cnnben002/SHARC-Buoy-Power-Module/(list of files, cad)

Other CAD files:
Power Module/Power Management Module V1.0/LIB_TC2030-MCP-NL/TC2030-MCP-NL/Allegro/tc2030-mcp-nl.psm
Power Module/Power Management Module V1.0/LIB_TC2030-MCP-NL/TC2030-MCP-NL/DEHDL/tc2030_mcp_nl/chips/chips.prt
Power Module/Power Management Module V1.1/LIB_TC2030-MCP-NL/TC2030-MCP-NL/Allegro/tc2030-mcp-nl.psm
Power Module/Power Management Module V1.1/LIB_TC2030-MCP-NL/TC2030-MCP-NL/DEHDL/tc2030_mcp_nl/chips/chips.prt
Power Module/Power Management Module V1.2/LIB_TC2030-MCP-NL/TC2030-MCP-NL/Allegro/tc2030-mcp-nl.psm
Power Module/Power Management Module V1.2/LIB_TC2030-MCP-NL/TC2030-MCP-NL/DEHDL/tc2030_mcp_nl/chips/chips.prt
