cnnben002/SHARC-Buoy-Power-Module/Power Module/Power Management Module V1.0/Power_Management_Module.kicad_pcb

## KiCad design Power Module/Power Management Module V1.0/Power_Management_Module.kicad_pcb (2022-11-06, an earlier design)

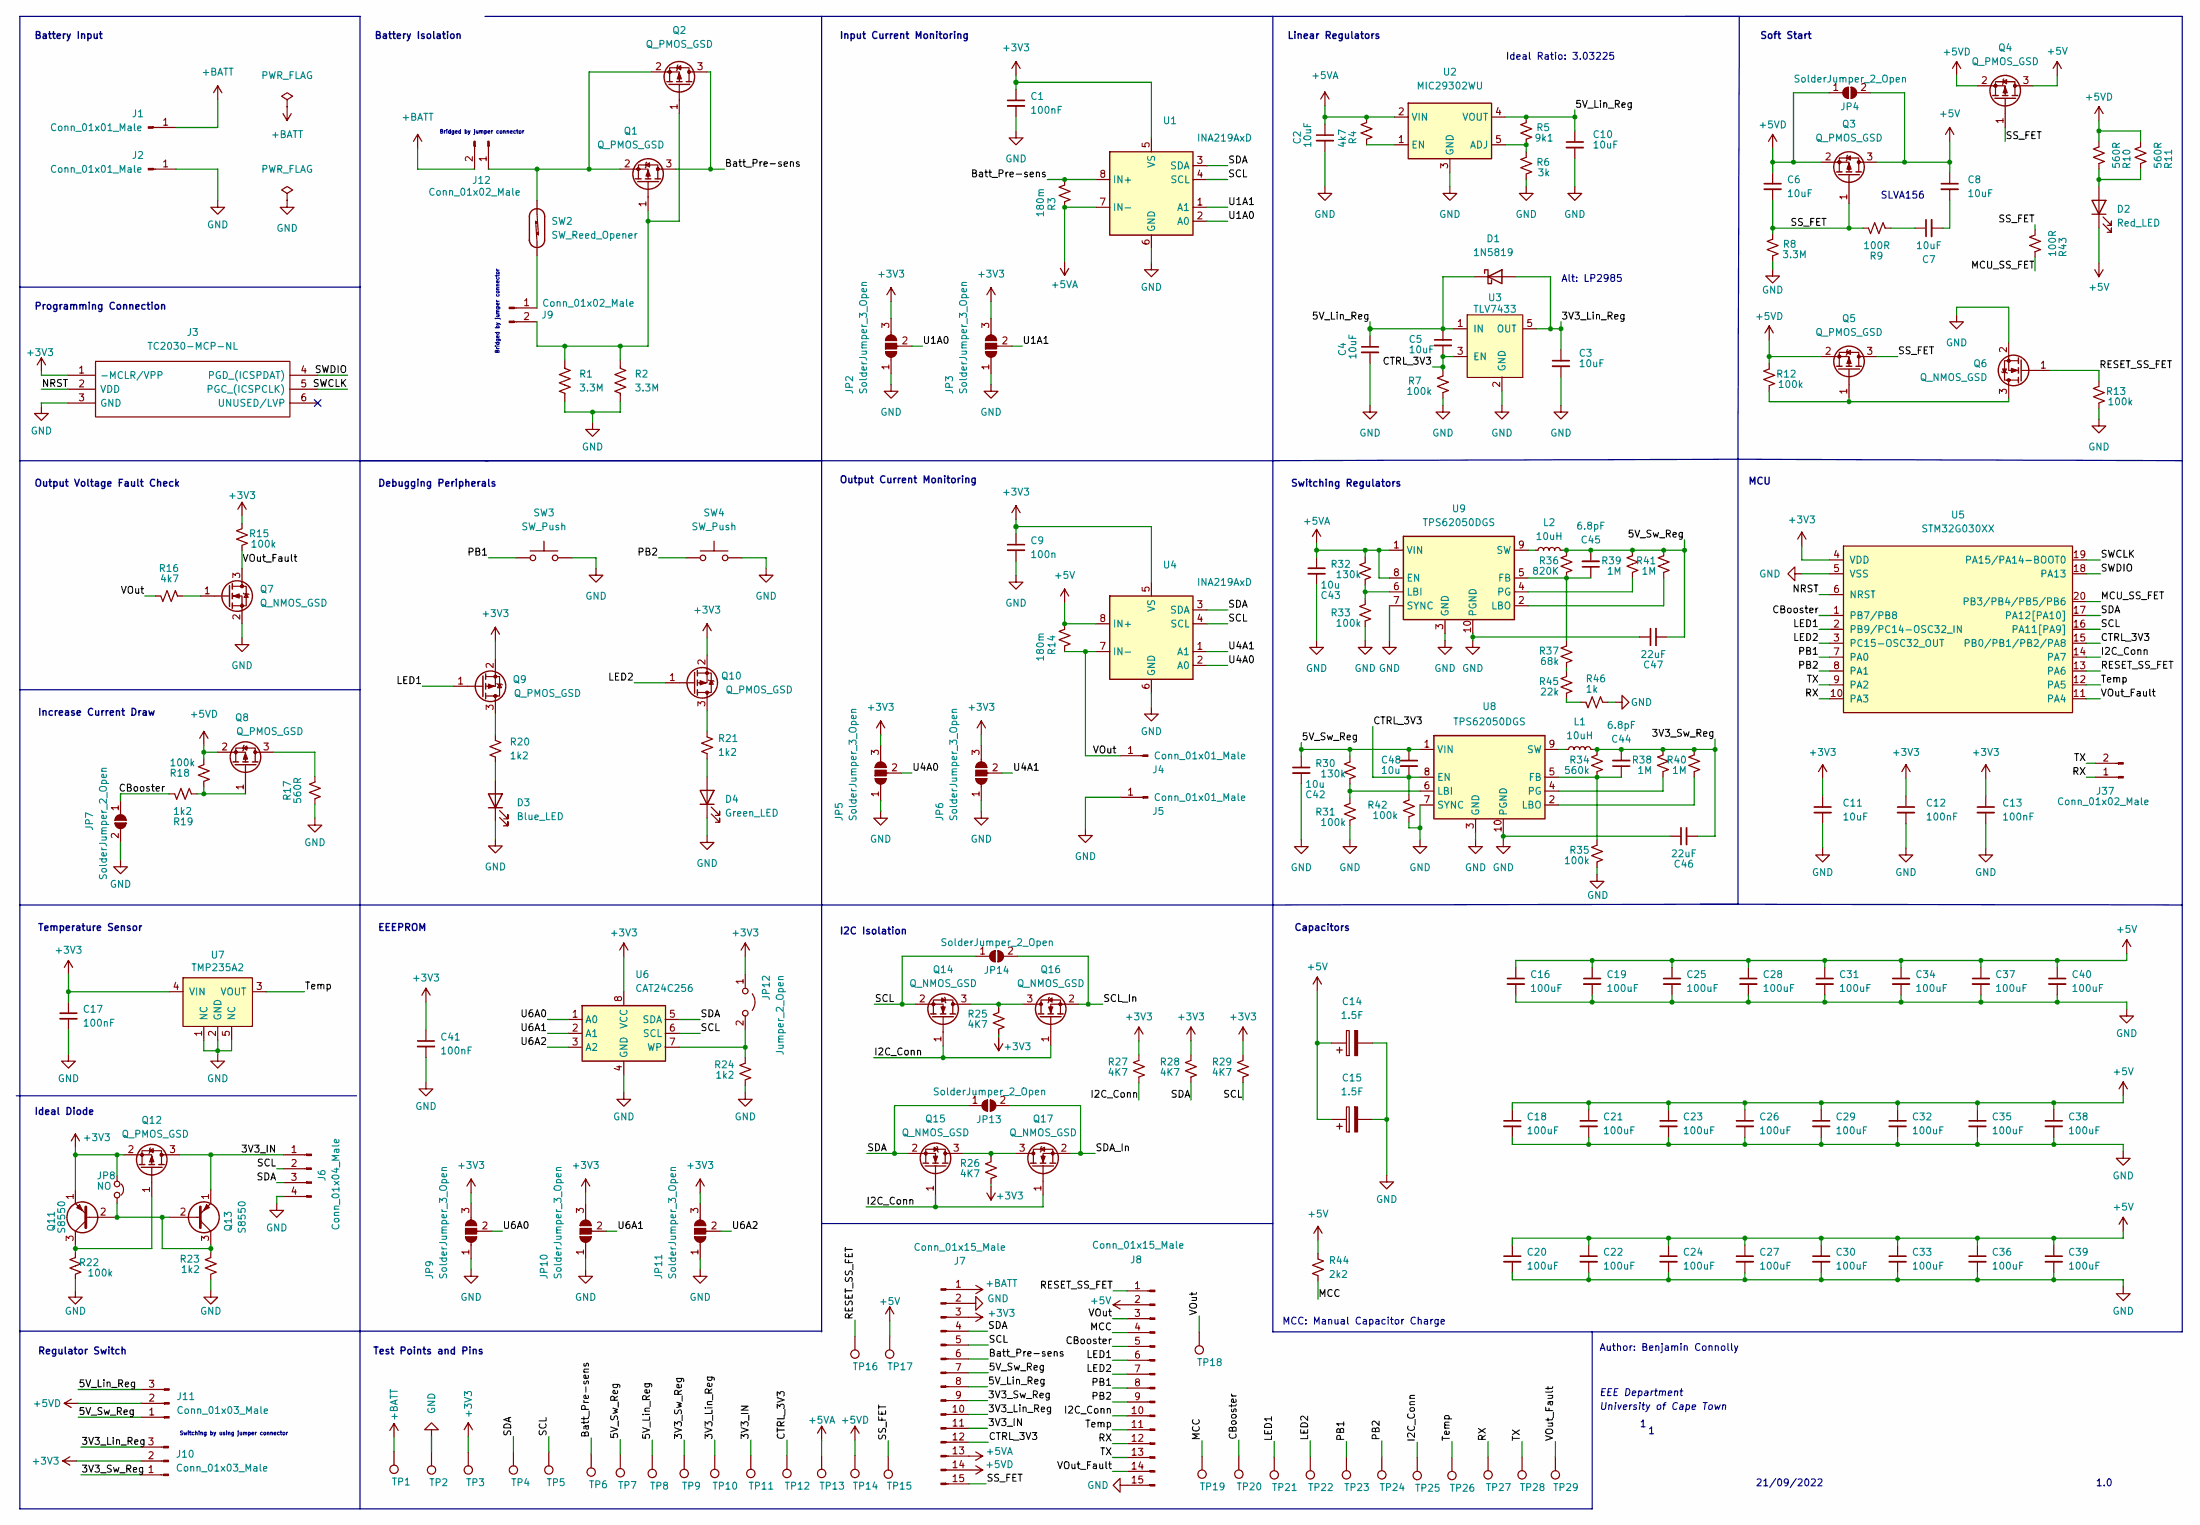
[picture p1: schematic Power_Management_Module.kicad_sch]

Parts:
C1, C12, C13, C41: 100nF; C_0402_1005Metric
C2, C3, C4, C5, C6, C7, C8, C10, C11: 10uF; C_0603_1608Metric
C9: 100n; C_0402_1005Metric
C14, C15: 1.5F; SP-5R5-Z155VY
C16, C18, C19, C20, C21, C22, C23, C24, C25, C26, C27, C28, C29, C30, C31, C32, C33, C34, C35, C36, C37, C38, C39, C40: 100uF; C_1206_3216Metric
C17: 100nF; C_1206_3216Metric
C42, C43, C48: 10u; C_0603_1608Metric
C44, C45: 6.8pF; C_0603_1608Metric
C46, C47: 22uF; CP_Elec_6.3x4.9
D1: 1N5819; D_SOD-323
D2: Red_LED; LED_0603_1608Metric
D3: Blue_LED; LED_0603_1608Metric
D4: Green_LED; LED_0603_1608Metric
J1, J2, J4, J5: Conn_01x01_Male; Battery_Pad
J3: TC2030-MCP-NL; Tag-Connect_TC2030-IDC-NL_2x03_P1.27mm_Vertical; Manufacturer_Part_Number TC2030-MCP-NL; Mouser Part Number 579-TC2030-MCP-NL
J6: Conn_01x04_Male; PinHeader_1x04_P2.54mm_Vertical
J7, J8: Conn_01x15_Male; PinHeader_1x15_P2.54mm_Vertical
J9, J12, J37: Conn_01x02_Male; PinHeader_1x02_P2.54mm_Vertical
J10, J11: Conn_01x03_Male; PinHeader_1x03_P2.54mm_Vertical
JP2, JP3, JP5, JP6, JP9, JP10, JP11: SolderJumper_3_Open; SolderJumper-3_P2.0mm_Open_TrianglePad1.0x1.5mm
JP4, JP7, JP13, JP14: SolderJumper_2_Open; SolderJumper-2_P1.3mm_Open_RoundedPad1.0x1.5mm
JP8: NO; SolderJumper-2_P1.3mm_Open_RoundedPad1.0x1.5mm
JP12: Jumper_2_Open; SolderJumper-2_P1.3mm_Open_RoundedPad1.0x1.5mm
L1, L2: 10uH; L_1008_2520Metric_Pad1.43x2.20mm_HandSolder
Q1, Q2, Q3, Q4, Q5, Q8, Q9, Q10, Q12: Q_PMOS_GSD; SOT-23
Q6, Q7, Q14, Q15, Q16, Q17: Q_NMOS_GSD; SOT-23
Q11, Q13: S8550; SOT-23
R1, R2: 3.3M; R_0603_1608Metric
R3, R14: 180m; R_2512_6332Metric; LCSC C25076
R4, R16: 4k7; R_0402_1005Metric; LCSC C25076
R5: 9k1; R_2512_6332Metric_Pad1.40x3.35mm_HandSolder; LCSC C25076
R6: 3k; R_2512_6332Metric_Pad1.40x3.35mm_HandSolder; LCSC C25076
R7, R12, R13, R15, R18, R22, R31, R33, R35, R42: 100k; R_0402_1005Metric; LCSC C25076
R8: 3.3M; R_0603_1608Metric; LCSC C25076
R9, R43: 100R; R_0402_1005Metric; LCSC C25076
R10, R11, R17: 560R; R_0603_1608Metric; LCSC C25076
R19, R23, R24: 1k2; R_0402_1005Metric; LCSC C25076
R20, R21: 1k2; R_0402_1005Metric
R25, R26, R27, R28, R29: 4K7; R_0402_1005Metric; LCSC C25076
R30, R32: 130k; R_2512_6332Metric_Pad1.40x3.35mm_HandSolder; LCSC C25076
R34: 560k; R_0402_1005Metric; LCSC C25076
R36: 820K; R_0402_1005Metric; LCSC C25076
R37: 68k; R_0805_2012Metric; LCSC C25076
R38, R39, R40, R41: 1M; R_1206_3216Metric; LCSC C25076
R44: 2k2; R_0402_1005Metric
R45: 22k; R_0603_1608Metric; LCSC C25076
R46: 1k; R_0805_2012Metric; LCSC C25076
SW2: SW_Reed_Opener; SW_SPST_REED_CUSTOM_1
SW3, SW4: SW_Push; SW_SPST_TL3342
TP1, TP2, TP3, TP4, TP5, TP6, TP7, TP8, TP9, TP10, TP11, TP12, TP13, TP14, TP15, TP16, TP17, TP18, TP19, TP20, TP21, TP22, TP23, TP24, TP25, TP26, TP27, TP28, TP29: TestPoint; TestPoint_Pad_2.0x2.0mm
U1, U4: INA219AxD; SOIC-8_3.9x4.9mm_P1.27mm
U2: MIC29302WU; TO-263-5_TabPin3
U3: TLV7433; SOT-23-5_HandSoldering; LCSC DNP
U5: STM32G030XX; TSSOP-20_4.4x6.5mm_P0.65mm; LCSC C529330
U6: CAT24C256; SOIC-8_3.9x4.9mm_P1.27mm
U7: TMP235A2; SOT-353_SC-70-5; LCSC DNP
U8, U9: TPS62050DGS; VSSOP-10_3x3mm_P0.5mm

Connections:
+3V3: C1.1, C9.1, C11.1, C12.1, C13.1, C17.1, C41.1, J3.1 (-MCLR/VPP), J7.3, J10.2, JP2.3 (B), JP3.3 (B), JP5.3 (B), JP6.3 (B), JP8.2, JP9.3 (B), JP10.3 (B), JP11.3 (B), JP12.1 (A), Q9.2 (S), Q10.2 (S), Q11.1 (E), Q12.2 (S), R15.1, R25.2, R26.2, R27.1, R28.1, R29.1, TP3.1, U1.5 (VS), U4.5 (VS), U5.4 (VDD), U6.8 (VCC), U7.4 (VIN)
+5V: C8.1, C14.1, C15.1, C16.1, C18.1, C19.1, C20.1, C21.1, C22.1, C23.1, C24.1, C25.1, C26.1, C27.1, C28.1, C29.1, C30.1, C31.1, C32.1, C33.1, C34.1, C35.1, C36.1, C37.1, C38.1, C39.1, C40.1, D2.1 (K), J8.2, JP4.2 (B), Q3.3 (D), Q4.3 (D), R14.1, R44.1, TP17.1, U4.8 (IN+)
+5VA: C2.1, C43.1, J7.13, R3.2, R4.1, R32.1, TP13.1, U1.7 (IN-), U2.2 (VIN), U9.1 (VIN), U9.8 (EN)
+5VD: C6.1, J7.14, J11.2, JP4.1 (A), Q3.2 (S), Q4.2 (S), Q5.2 (S), Q8.2 (S), R10.2, R11.2, R12.1, R18.2, TP14.1
+BATT: J1.1, J7.1, J12.2, TP1.1
/3V3_IN: J6.1, J7.11, Q12.3 (D), Q13.1 (E), TP11.1
/3V3_Lin_Reg: C3.1, D1.2 (A), J7.10, J10.3, TP10.1, U3.5 (OUT)
/3V3_Sw_Reg: C44.2, C46.2, J7.9, J10.1, L1.2, R34.1, R38.1, R40.1, TP9.1
/5V_Lin_Reg: C4.1, C5.1, C10.1, D1.1 (K), J7.8, J11.3, R5.1, TP8.1, U2.4 (VOUT), U3.1 (IN)
/5V_Sw_Reg: C42.1, C45.2, C47.2, C48.1, J7.7, J11.1, L2.2, R30.1, R36.1, R39.1, R41.1, TP7.1, U8.1 (VIN)
/Batt_Pre-sens: J7.6, Q1.3 (D), Q2.3 (D), R3.1, TP6.1, U1.8 (IN+)
/CBooster: J8.5, JP7.1 (A), R19.2, TP20.1, U5.1 (PB7/PB8)
/CTRL_3V3: C5.2, C48.2, J7.12, R7.1, R42.1, TP12.1, U3.3 (EN), U5.15 (PB0/PB1/PB2/PA8), U8.8 (EN)
/I2C_Conn: J8.10, Q14.1 (G), Q15.1 (G), Q16.1 (G), Q17.1 (G), R27.2, TP25.1, U5.14 (PA7)
/LED1: J8.6, Q9.1 (G), TP21.1, U5.2 (PB9/PC14-OSC32_IN)
/LED2: J8.7, Q10.1 (G), TP22.1, U5.3 (PC15-OSC32_OUT)
/MCC: J8.4, R44.2, TP19.1
/MCU_SS_FET: R43.1, U5.20 (PB3/PB4/PB5/PB6)
/NRST: J3.2 (VDD), U5.6 (NRST)
/PB1: J8.8, SW3.1, TP23.1, U5.7 (PA0)
/PB2: J8.9, SW4.1, TP24.1, U5.8 (PA1)
/RESET_SS_FET: J8.1, Q6.1 (G), R13.1, TP16.1, U5.13 (PA6)
/RX: J8.12, J37.1, TP27.1, U5.10 (PA3)
/SCL: J6.2, J7.5, JP14.1 (A), Q14.2 (S), R29.2, TP5.1, U1.4 (SCL), U4.4 (SCL), U5.16 (PA11[PA9]), U6.6 (SCL)
/SCL_In: JP14.2 (B), Q16.2 (S)
/SDA: J6.3, J7.4, JP13.1 (A), Q15.2 (S), R28.2, TP4.1, U1.3 (SDA), U4.3 (SDA), U5.17 (PA12[PA10]), U6.5 (SDA)
/SDA_In: JP13.2 (B), Q17.2 (S)
/SS_FET: C6.2, J7.15, Q3.1 (G), Q4.1 (G), Q5.3 (D), R8.1, R9.1, R43.2, TP15.1
/SWCLK: J3.5 (PGC_(ICSPCLK)), U5.19 (PA15/PA14-BOOT0)
/SWDIO: J3.4 (PGD_(ICSPDAT)), U5.18 (PA13)
/TX: J8.13, J37.2, TP28.1, U5.9 (PA2)
/Temp: J8.11, TP26.1, U5.12 (PA5), U7.3 (VOUT)
/U1A0: JP2.2 (C), U1.2 (A0)
/U1A1: JP3.2 (C), U1.1 (A1)
/U4A0: JP5.2 (C), U4.2 (A0)
/U4A1: JP6.2 (C), U4.1 (A1)
/U6A0: JP9.2 (C), U6.1 (A0)
/U6A1: JP10.2 (C), U6.2 (A1)
/U6A2: JP11.2 (C), U6.3 (A2)
/VOut: J4.1, J8.3, R14.2, R16.1, TP18.1, U4.7 (IN-)
/VOut_Fault: J8.14, Q7.3 (D), R15.2, TP29.1, U5.11 (PA4)
GND: C1.2, C2.2, C3.2, C4.2, C9.2, C10.2, C11.2, C12.2, C13.2, C14.2, C15.2, C16.2, C17.2, C18.2, C19.2, C20.2, C21.2, C22.2, C23.2, C24.2, C25.2, C26.2, C27.2, C28.2, C29.2, C30.2, C31.2, C32.2, C33.2, C34.2, C35.2, C36.2, C37.2, C38.2, C39.2, C40.2, C41.2, C42.2, C43.2, C46.1, C47.1, D3.1 (K), D4.1 (K), J2.1, J3.3 (GND), J5.1, J6.4, J7.2, J8.15, JP2.1 (A), JP3.1 (A), JP5.1 (A), JP6.1 (A), JP7.2 (B), JP9.1 (A), JP10.1 (A), JP11.1 (A), Q6.2 (S), Q7.2 (S), R1.2, R2.2, R6.2, R7.2, R8.2, R13.2, R17.1, R22.2, R23.2, R24.2, R31.2, R33.2, R35.2, R42.2, R46.1, SW3.2, SW4.2, TP2.1, U1.6 (GND), U2.3 (GND), U3.2 (GND), U4.6 (GND), U5.5 (VSS), U6.4 (GND), U7.1 (NC), U7.2 (GND), U7.5 (NC), U8.3 (GND), U8.7 (SYNC), U8.10 (PGND), U9.3 (GND), U9.7 (SYNC), U9.10 (PGND)
unnamed: C7.1, R9.2
unnamed: C7.2, C8.2
unnamed: C44.1, R34.2, R35.1, U8.5 (FB)
unnamed: C45.1, R36.2, R37.1, U9.5 (FB)
unnamed: D2.2 (A), R10.1, R11.1
unnamed: D3.2 (A), R20.2
unnamed: D4.2 (A), R21.2
unnamed: J9.1, SW2.2
unnamed: J9.2, Q1.1 (G), Q2.1 (G), R1.1, R2.1
unnamed: J12.1, Q1.2 (S), Q2.2 (S), SW2.1
unnamed: JP8.1, Q11.2 (B), Q13.2 (B), Q13.3 (C), R23.1
unnamed: JP12.2 (B), R24.1, U6.7 (WP)
unnamed: L1.1, U8.9 (SW)
unnamed: L2.1, U9.9 (SW)
unnamed: Q5.1 (G), Q6.3 (D), R12.2
unnamed: Q7.1 (G), R16.2
unnamed: Q8.1 (G), R18.1, R19.1
unnamed: Q8.3 (D), R17.2
unnamed: Q9.3 (D), R20.1
unnamed: Q10.3 (D), R21.1
unnamed: Q11.3 (C), Q12.1 (G), R22.1
unnamed: Q14.3 (D), Q16.3 (D), R25.1
unnamed: Q15.3 (D), Q17.3 (D), R26.1
unnamed: R4.2, U2.1 (EN)
unnamed: R5.2, R6.1, U2.5 (ADJ)
unnamed: R30.2, R31.1, U8.6 (LBI)
unnamed: R32.2, R33.1, U9.6 (LBI)
unnamed: R37.2, R45.1
unnamed: R38.2, U8.4 (PG)
unnamed: R39.2, U9.4 (PG)
unnamed: R40.2, U8.2 (LBO)
unnamed: R41.2, U9.2 (LBO)
unnamed: R45.2, R46.2

Notes on the sheet:
Debugging Peripherals
Programming Connection
Capacitors
Soft Start
Input Current Monitoring
Linear Regulators
Output Current Monitoring
MCU
Output Voltage Fault Check
Battery Input
Ideal Diode
Switching Regulators
I2C Isolation
Alt: LP2985
Regulator Switch
Battery Isolation
21/09/2022
Increase Current Draw
Temperature Sensor
Author: Benjamin Connolly
1.0
Ideal Ratio: 3.03225
Bridged by jumper connector
SLVA156
University of Cape Town
Switching by using jumper connector
Test Points and Pins
MCC: Manual Capacitor Charge
EEEPROM
EEE Department

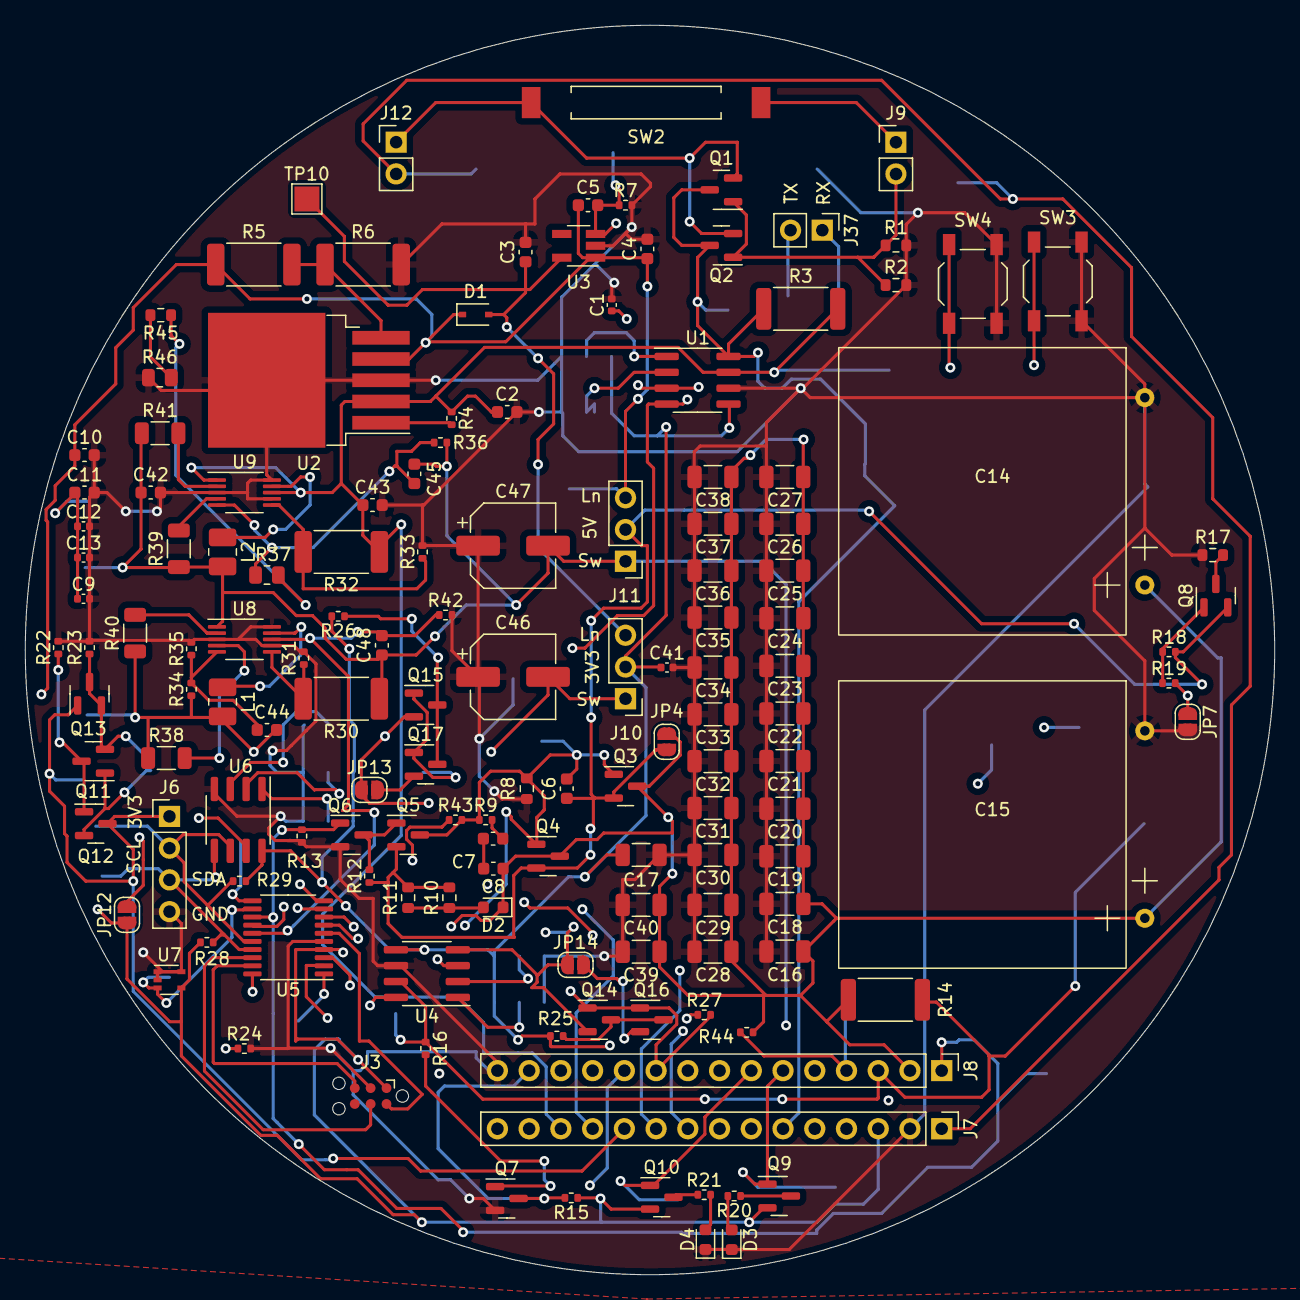
[picture p2: board Power_Management_Module.kicad_pcb from above]

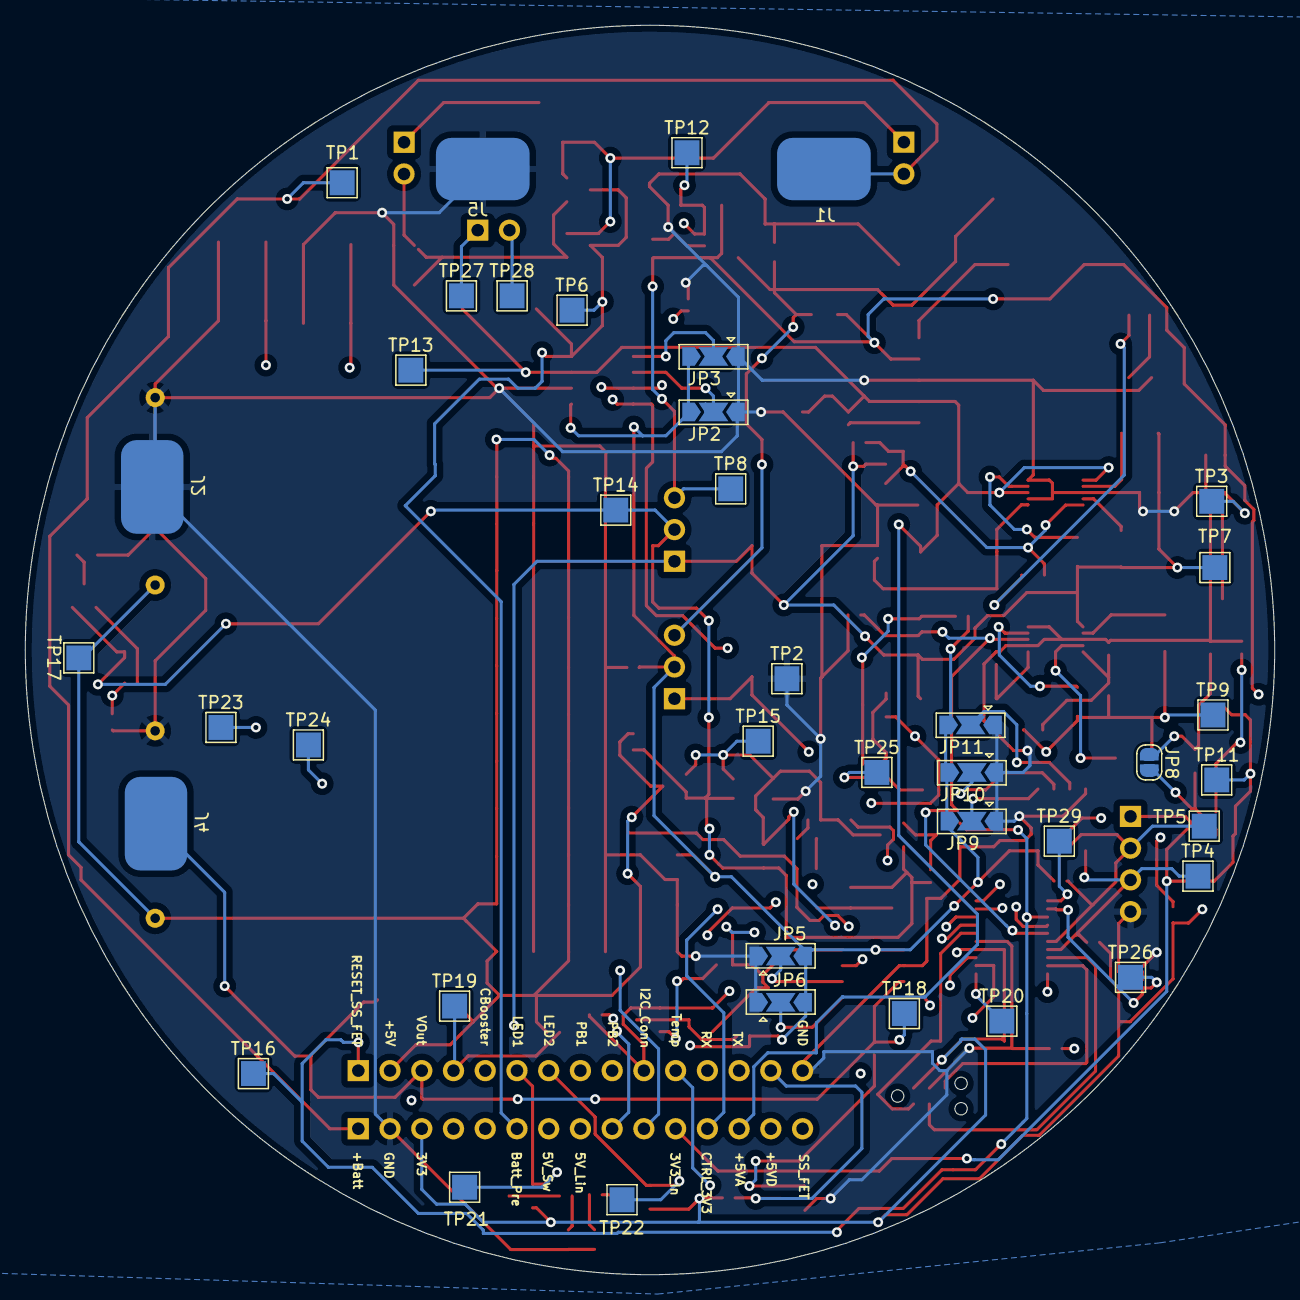
[picture p3: board Power_Management_Module.kicad_pcb from below]

Board: 4 copper layers, 100.0 x 100.0 mm, 184 parts (36 on the bottom side), 75 nets.
