cnnben002/SHARC-Buoy-Power-Module/Battery Test/Experiment Data/Cold Load Test.xlsx

Time | Time (s) | Temperature(C) | Voltage1(V) | Current1(mA) | Power1(mW) | ShuntVoltage1(mV)
1665881172 | 0 | -13.4 | 6.764 | 346.585 | 2345 | 34.65
1665881182 | 10 | -13.4 | 6.764 | 346.393 | 2344.146 | 34.65
1665881192 | 20 | -13.4 | 6.76 | 346.287 | 2342.866 | 34.63
1665881202 | 30 | -13.4 | 6.76 | 346.095 | 2339.878 | 34.62
1665881212 | 40 | -13.4 | 6.764 | 345.881 | 2339.878 | 34.6
1665881222 | 50 | -13.4 | 6.76 | 345.796 | 2338.598 | 34.58
1665881232 | 60 | -13.4 | 6.76 | 345.582 | 2335.61 | 34.57
1665881242 | 70 | -13.4 | 6.76 | 345.497 | 2335.61 | 34.55
1665881252 | 80 | -13.4 | 6.76 | 345.39 | 2335.183 | 34.54
1665881262 | 90 | -13.4 | 6.76 | 345.198 | 2334.329 | 34.52
1665881272 | 100 | -13.4 | 6.76 | 345.198 | 2333.049 | 34.51
1665881282 | 110 | -13.4 | 6.76 | 345.198 | 2333.476 | 34.51
1665881292 | 120 | -13.4 | 6.76 | 345.091 | 2335.183 | 34.51
1665881302 | 130 | -13.4 | 6.76 | 345.198 | 2333.476 | 34.52
1665881312 | 140 | -13.4 | 6.76 | 344.985 | 2332.195 | 34.5
1665881322 | 150 | -13.4 | 6.76 | 344.878 | 2332.195 | 34.49
1665881332 | 160 | -13.4 | 6.76 | 344.793 | 2330.061 | 34.47
1665881342 | 170 | -13.4 | 6.76 | 344.387 | 2328.78 | 34.45
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
