cnnben002/SHARC-Buoy-Power-Module/Battery Test/Experiment Data/Warm Load Test.xlsx

Time | Time (s) | Temperature(C) | Voltage1(V) | Current1(mA) | Power1(mW) | ShuntVoltage1(mV)
1666772531 | 0 | 21.1 | 6.74 | 350.598 | 2362.927 | 35.07
1666772541 | 10 | 21.1 | 6.708 | 350.598 | 2356.098 | 35.06
1666772551 | 20 | 21.1 | 6.724 | 350.683 | 2358.232 | 35.06
1666772561 | 30 | 21.1 | 6.78 | 350.683 | 2380 | 35.07
1666772571 | 40 | 21.1 | 6.824 | 350.683 | 2393.232 | 35.07
1666772581 | 50 | 21.1 | 6.816 | 350.598 | 2390.244 | 35.08
1666772591 | 60 | 21.1 | 6.812 | 350.384 | 2388.11 | 35.04
1666772601 | 70 | 21.1 | 6.712 | 350.085 | 2348.415 | 35
1666772611 | 80 | 21.1 | 6.648 | 349.893 | 2325.793 | 34.99
1666772621 | 90 | 21.1 | 6.664 | 349.893 | 2333.476 | 35
1666772631 | 100 | 21.1 | 6.708 | 349.787 | 2347.561 | 34.99
1666772641 | 110 | 21.1 | 6.704 | 349.787 | 2345 | 34.98
1666772652 | 120 | 21.1 | 6.652 | 349.787 | 2327.927 | 35.01
1666772662 | 130 | 21.1 | 6.66 | 349.979 | 2330.915 | 35
1666772672 | 140 | 21.1 | 6.672 | 349.979 | 2335.183 | 35
1666772682 | 150 | 21.1 | 6.68 | 349.979 | 2337.317 | 34.99
1666772692 | 160 | 21.1 | 6.672 | 349.787 | 2334.329 | 34.99
1666772702 | 170 | 21.1 | 6.656 | 349.893 | 2329.634 | 34.97
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
