cnnben002/SHARC-Buoy-Power-Module/Battery Test/Oscilloscope Images/scope_0.png

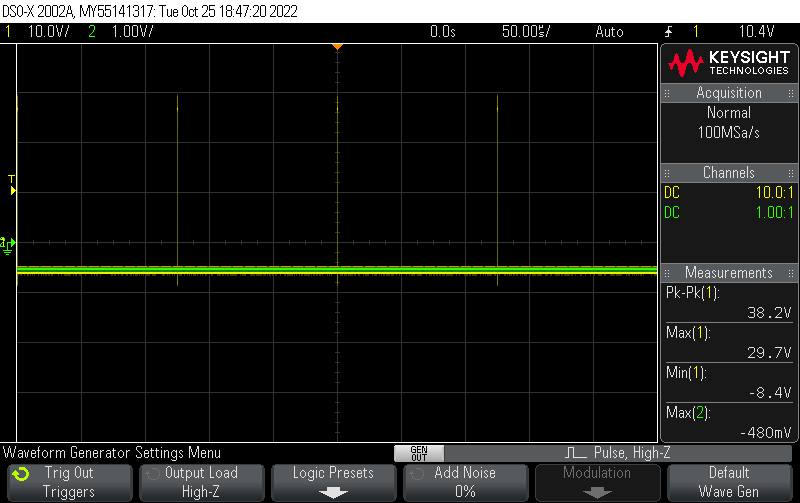
Battery Test/Oscilloscope Images/scope_0.png
