cnnben002/SHARC-Buoy-Power-Module/Battery Test/Oscilloscope Images/scope_1.png

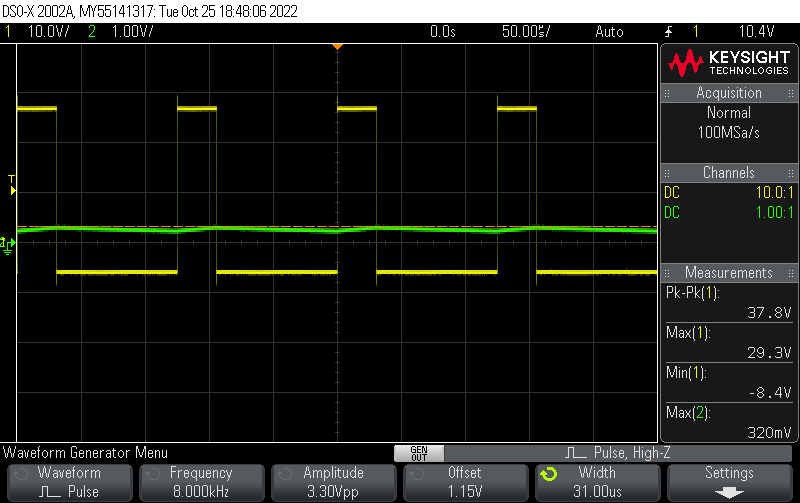
Battery Test/Oscilloscope Images/scope_1.png
