cnnben002/SHARC-Buoy-Power-Module/Battery Test/Oscilloscope Images/scope_2.png

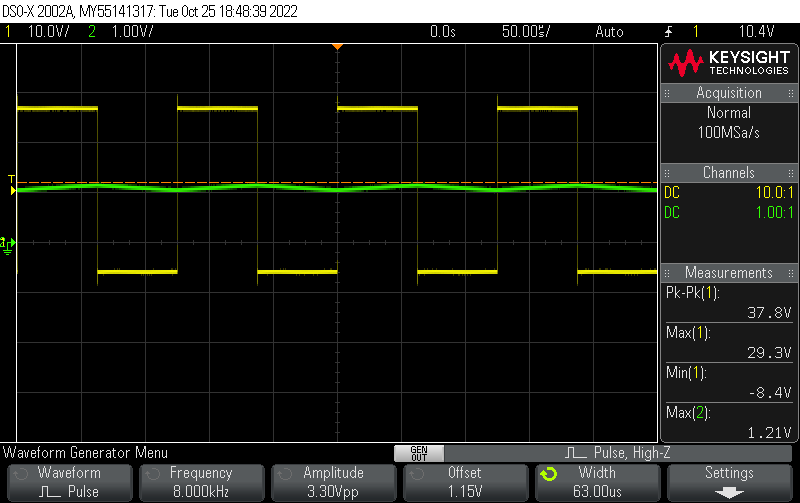
Battery Test/Oscilloscope Images/scope_2.png
