cnnben002/SHARC-Buoy-Power-Module/Battery Test/Oscilloscope Images/scope_3.png

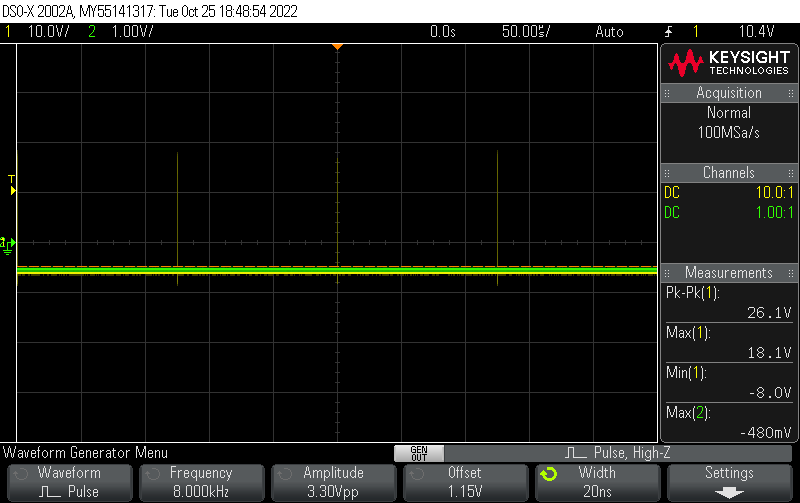
Battery Test/Oscilloscope Images/scope_3.png
