cnnben002/SHARC-Buoy-Power-Module/Battery Test/Oscilloscope Images/scope_8.png

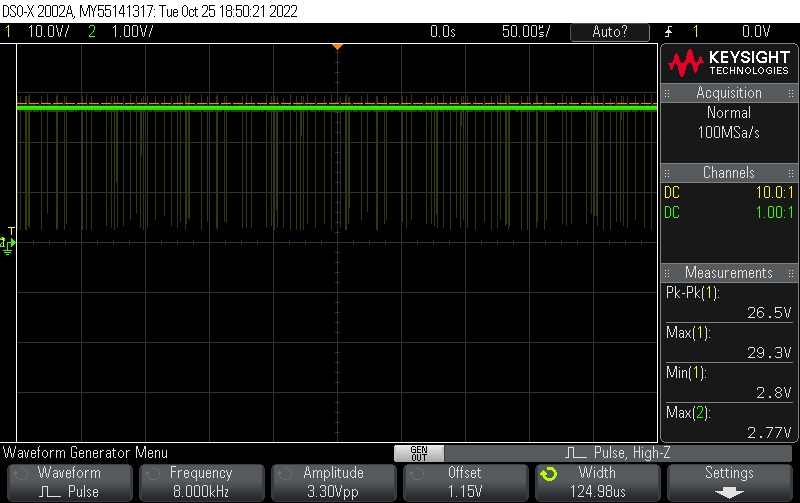
Battery Test/Oscilloscope Images/scope_8.png
