cnnben002/SHARC-Buoy-Power-Module/(notices)

Notices in the files:
STM32 Code/main.c:
Copyright (c) 2022 STMicroelectronics.
All rights reserved.
This software is licensed under terms that can be found in the LICENSE file
